danielje/Smart-Trap-Lighting-Hardware/Trap Light Programmable SpectrumV03 BOM New Variant 05-16-2018.xls

Bill of Materials for pc board: "Trap Light Programmable SpectrumV03.brd" as of 5-11-2018
Designator | Item | Quantity | for 120 | w overage | Designator | Description | Value | Package | Type | Manufacturer | Mfctr. Part Number | Distributor | Dstbr. Part # | Cost Each | Total parts cost | Incl. In Kit | Need for Build | Qty. To Return | Comments
TrapL1 | 1 | 1 | 120 | 125 | A1 | MODULE BLUETOOTH V2.1+EDR |  |  | smt | Microchip Technology (http://digikey.com/Suppliers/us/Microchip-Technology.page?lang=en) | RN42-I/RM | Digikey | 740-1038-1-ND | $15.44 | $15.44
TrapL2 | 2 | 4 | 480 | 580 | C1 - C4 | CAP CER 0.1UF 16V X7R 0805 | 0.1 uF | 0805 | smt | Johanson Dielectrics Inc. | 160R15W104KV4T | Digikey | 709-1183-1-ND | $0.06 | $0.22
TrapL3 | 3 | 2 | 240 | 340 | C5 - C6 | CAP CER 4.7UF 10V X7R 0805 | 4.7 uF | 0805 | smt | TDK Corporation | C2012X7R1A475M085AC | Digikey | 445-14528-1-ND | $0.08 | $0.15
TrapL4 | 4 | 6 | 720 | 820 | C7 - C12 | CAP CER 10UF 16V 20% X5R 0805 | 10 uF | 0805 | smt | TDK Corporation (http://digikey.com/Suppliers/us/TDK.page?lang=en) | C2012X5R1C106M085AC | Digikey | 445-7645-1-ND | $0.06 | $0.38
TrapL5 | 5 | 3 | 360 | 460 | C13 - C15 | CAP CER 22UF 16V 20% X5R 1206 | 22 uF | 1206 | smt | Taiyo Yuden (http://digikey.com/Suppliers/us/Taiyo-Yuden.page?lang=en) | EMK316BJ226ML-T | Digikey | 587-1433-1-ND | $0.14 | $0.41
TrapL6 | 6 | 1 | 120 | 220 | C16 | CAP CER 10PF 50V C0G/NP0 0805 | 10 pF | 0805 | smt | KEMET | C0805C100J5GACAUTO | Digikey | 399-6914-1-ND | $0.02 | $0.02
TrapL7 | 7 | 1 | 120 | 220 | C17 | CAP CER 1UF 25V Y5V 0805 | 1 uF | 0805 | smt | Samsung Electro-Mechanics America, Inc (http://digikey.com/Suppliers/us/samsung-electro-mechanics.page?lang=en) | CL21F105ZAFNNNE | Digikey | 1276-3009-1-ND | $0.02 | $0.02
TrapL8 | 8 | 3 | 360 | 460 | D1, D2 | DIODE SCHOTTKY 40V 1A SOD123 |  | SOD123 | smt | Nexperia USA Inc. (https://www.digikey.com/en/supplier-centers/n/nexperia) | PMEG4010CEGWX | Digikey | 1727-7337-1-ND | $0.12 | $0.37
TrapL9 | 9 | 1 | 120 | 145 | IC1 | IC CONTROLLR LI-ION 4.2V SOT23-5 |  | SOT23-5 | smt | Microchip Technology (http://digikey.com/Suppliers/us/Microchip-Technology.page?lang=en) | MCP73831T-2ACI/OT | Digikey | MCP73831T-2ACI/OTCT-ND | $0.42 | $0.42
TrapL10 | 10 | 1 | 120 | 145 | IC2 | IC VOLT DETECTOR 2CH LOP 6SOT |  | 6SOT | smt | Texas Instruments | TPS3710DDCR | Digikey | 296-43105-1-ND | $1.14 | $1.14
TrapL11 | 11 | 1 | 120 | 145 | IC3 | IC REG BUCK BST 3.3V 0.9A 10SON |  | 10SON | smt | Texas Instruments | TPS63031DSKR | Digikey | 296-39461-1-ND | $1.39 | $1.39
TrapL12 | 12 | 1 | 120 | 145 | IC4 | IC REG BUCK BOOST ADJ 2A 10WSON |  | 10WSON | smt | Texas Instruments | TPS63060DSCR | Digikey | 296-30204-1-ND | $1.74 | $1.74
TrapL13 | 13 | 1 | 120 | 145 | IC5 | IC MCU 8BIT 32KB FLASH 32TQFP |  | 32TQFP | smt | Atmel (http://digikey.com/Suppliers/us/Atmel.page?lang=en) | ATMEGA328P-AU | Digikey | ATMEGA328P-AURCT-ND | $1.70 | $1.70
TrapL14 | 14 | 6 | 720 | 745 | IC6 - IC11 | IC LED DRVR LIN DIM 40MA SC70-6 |  | SC-70-6 | smt | ams (http://digikey.com/Suppliers/us/Texas-Instruments.page?lang=en) | AS1102-T | Digikey | AS1102-TCT-ND | $0.59 | $3.52
TrapL15 | 15 | 1 | 120 | 25 | J1 | CONN HEADER PH SIDE 2POS 2MM SMD |  | JST | smt | JST Sales America Inc. (https://www.digikey.com/en/supplier-centers/j/jst) | S2B-PH-SM4-TB(LF)(SN) | Digikey | 455-1749-1-ND | $0.42 | $0.42
TrapL16 | 16 | 1 | 120 | 130 | J2 | CONN TERM BLK 2POS 2.5MM SMD |  |  | smt | Phoenix Contact (http://digikey.com/Suppliers/us/Phoenix-Contact.page?lang=en) | 1771091 | Digikey | 277-2072-1-ND | $0.64 | $0.64
TrapL17 | 17 | 1 | 120 | 145 | J3 | 2MM TERMINAL STRIP |  |  | smt | Samtec Inc. (https://www.digikey.com/en/supplier-centers/s/samtec) | TMM-102-01-F-S-SM | Digikey | SAM12135-ND | $0.23 | $0.23
TrapL18 | 18 | 2 | 240 | 265 | L1, L2 | FIXED IND 2.2UH 1.95A 66 MOHM |  |  | smt | TDK Corporation | VLF302512MT-2R2M | Digikey | 445-6780-1-ND | $0.99 | $1.97
TrapL19 | 19 | 1 | 120 | 145 | LED1 | LED 0.33W RED WTR CLR 3.5MM | red | 2-SMD | smt | TT Electronics/Optek Technology (http://digikey.com/Suppliers/us/TT-Electronics-Optek-Technology.page?lang=en) | OVS5MRBCR4 | Digikey | 365-1546-1-ND | $0.36 | $0.36
TrapL20 | 20 | 1 | 120 | 145 | LED2 | LED 0.33W AMBER WTR CLR 3.5MM | amber | 2-SMD | smt | TT Electronics/Optek Technology (http://digikey.com/Suppliers/us/TT-Electronics-Optek-Technology.page?lang=en) | OVS5MABCR4 | Digikey | 365-1543-1-ND | $0.36 | $0.36
TrapL21 | 21 | 1 | 120 | 145 | LED3 | LED 0.33W YELLOW WTR CLR 3.5MM | yellow | 2-SMD | smt | TT Electronics/Optek Technology (http://digikey.com/Suppliers/us/TT-Electronics-Optek-Technology.page?lang=en) | OVS5MYBCR4 | Digikey | 365-1549-1-ND | $0.36 | $0.36
TrapL22 | 22 | 1 | 90 | 115 | LED4 | LED LUXEON 3535L GREEN 530NM | green | 1414 (3535 Metric) | smt | Lumileds | L135-G525003500000 | Digikey | 1416-1984-1-ND | $0.57 | $0.57
TrapL23 | 23 | 1 | 120 | 145 | LED5 | LED 0.33W BLUE WTR CLR 3.5MM | blue | 2-SMD | smt | TT Electronics/Optek Technology (http://digikey.com/Suppliers/us/TT-Electronics-Optek-Technology.page?lang=en) | OVS5MBBCR4 | Digikey | 365-1544-1-ND | $0.36 | $0.36
TrapL24Variant1 | 24 | 1 | 90 | 115 | LED6 | LED 500MA 970MW 385NM | UV | 2-SMD | smt | Lite-On Inc. (https://www.digikey.com/en/supplier-centers/l/lite-on) | LTPL-C034UVH385 | Digikey | 160-2185CT-ND | $4.39 | $4.39
TrapL24Variant2 | 24 | 1 | 30 | 55 | LED6 | LED 500MA 665MW 365NM | UV | 2-SMD | smt | Lite-On Inc. (https://www.digikey.com/en/supplier-centers/l/lite-on) | LTPL-C034UVH365 | Digikey | 160-2184CT-ND | $4.34 | $4.34
TrapL25 | 25 | 1 | 120 | 220 | LED7 | LED RED DIFFUSED 0805 SMD | red | 0805 | smt | OSRAM Opto Semiconductors Inc. (http://digikey.com/Suppliers/us/Wurth-Electronics.page?lang=en) | LH R974-LP-1 | Digikey | 475-1415-1-ND | $0.49 | $0.49
TrapL26 | 26 | 7 | 840 | 940 | R1 - R7 | RES SMD 27K OHM 5% 1/8W 0805 | 27 kW | 0805 | smt | Panasonic Electronic Components (http://digikey.com/Suppliers/us/Panasonic-Electronic-Components.page?lang=en) | ERJ-6GEYJ273V | Digikey | P27KACT-ND | $0.01 | $0.08
TrapL27 | 27 | 1 | 120 | 220 | R8, R9 | RES SMD 4.7K OHM 5% 1/8W 0805 | 4.7 kW | 0805 | smt | Panasonic Electronic Components (http://digikey.com/Suppliers/us/Panasonic-Electronic-Components.page?lang=en) | ERJ-6GEYJ472V | Digikey | P4.7KACT-ND | $0.01 | $0.02
TrapL28 | 28 | 2 | 240 | 340 | R10, R11 | RES SMD 200K OHM 1% 1/8W 0805 | 200 kW | 0806 | smt | Panasonic Electronic Components (http://digikey.com/Suppliers/us/Panasonic-Electronic-Components.page?lang=en) | ERJ-6ENF2003V | Digikey | P200KCCT-ND | $0.01 | $0.01
TrapL29 | 29 | 1 | 120 | 220 | R12 | RES 2K OHM 1/8W 5% 0805 SMD | 2 kW | 0805 | smt | Panasonic Electronic Components (http://digikey.com/Suppliers/us/Panasonic-Electronic-Components.page?lang=en) | ERJ-6GEYJ202V | Digikey | P2.0KACT-ND | $0.00459 | $0.00459
TrapL30 | 30 | 1 | 90 | 190 | R13 | RES SMD 1.4M OHM 1% 1/8W 0805 | 1.4M | 0805 | smt | Panasonic Electronic Components (http://digikey.com/Suppliers/us/Panasonic-Electronic-Components.page?lang=en) | ERJ-6ENF1404V | Digikey | P1.4BTCT-ND | $0.01 | $0.01
TrapL31 | 31 | 1 | 120 | 220 | R14, R15 | RES SMD 1.2M OHM 1% 1/8W 0805 | 1.2 MW | 0805 | smt | Panasonic Electronic Components (http://digikey.com/Suppliers/us/Panasonic-Electronic-Components.page?lang=en) | ERJ-6ENF1204V | Digikey | P1.20MCCT-ND | $0.01 | $0.01
TrapL32 | 32 | 1 | 120 | 130 | USB1 | Connector Receptacle USB micro B 5 Position Surface Mount, Right Angle, Horizontal | micro-USB |  | smt | Wurth Electronics Inc (http://digikey.com/Suppliers/us/Wurth-Electronics.page?lang=en) | 629105136821 | Digikey | 732-3155-1-ND | $1.14 | $1.14
 |  | 32 | unique components
 |  | 59 | total components (all smd)
 |  |  |  |  |  |  |  |  |  |  |  |  | total |  | $41.48
