danielje/Smart-Trap-Lighting-Hardware/Trap Lighting Programmable SpectrumV03B.brd

## EAGLE design Trap Lighting Programmable SpectrumV03B.brd (2021-06-18)

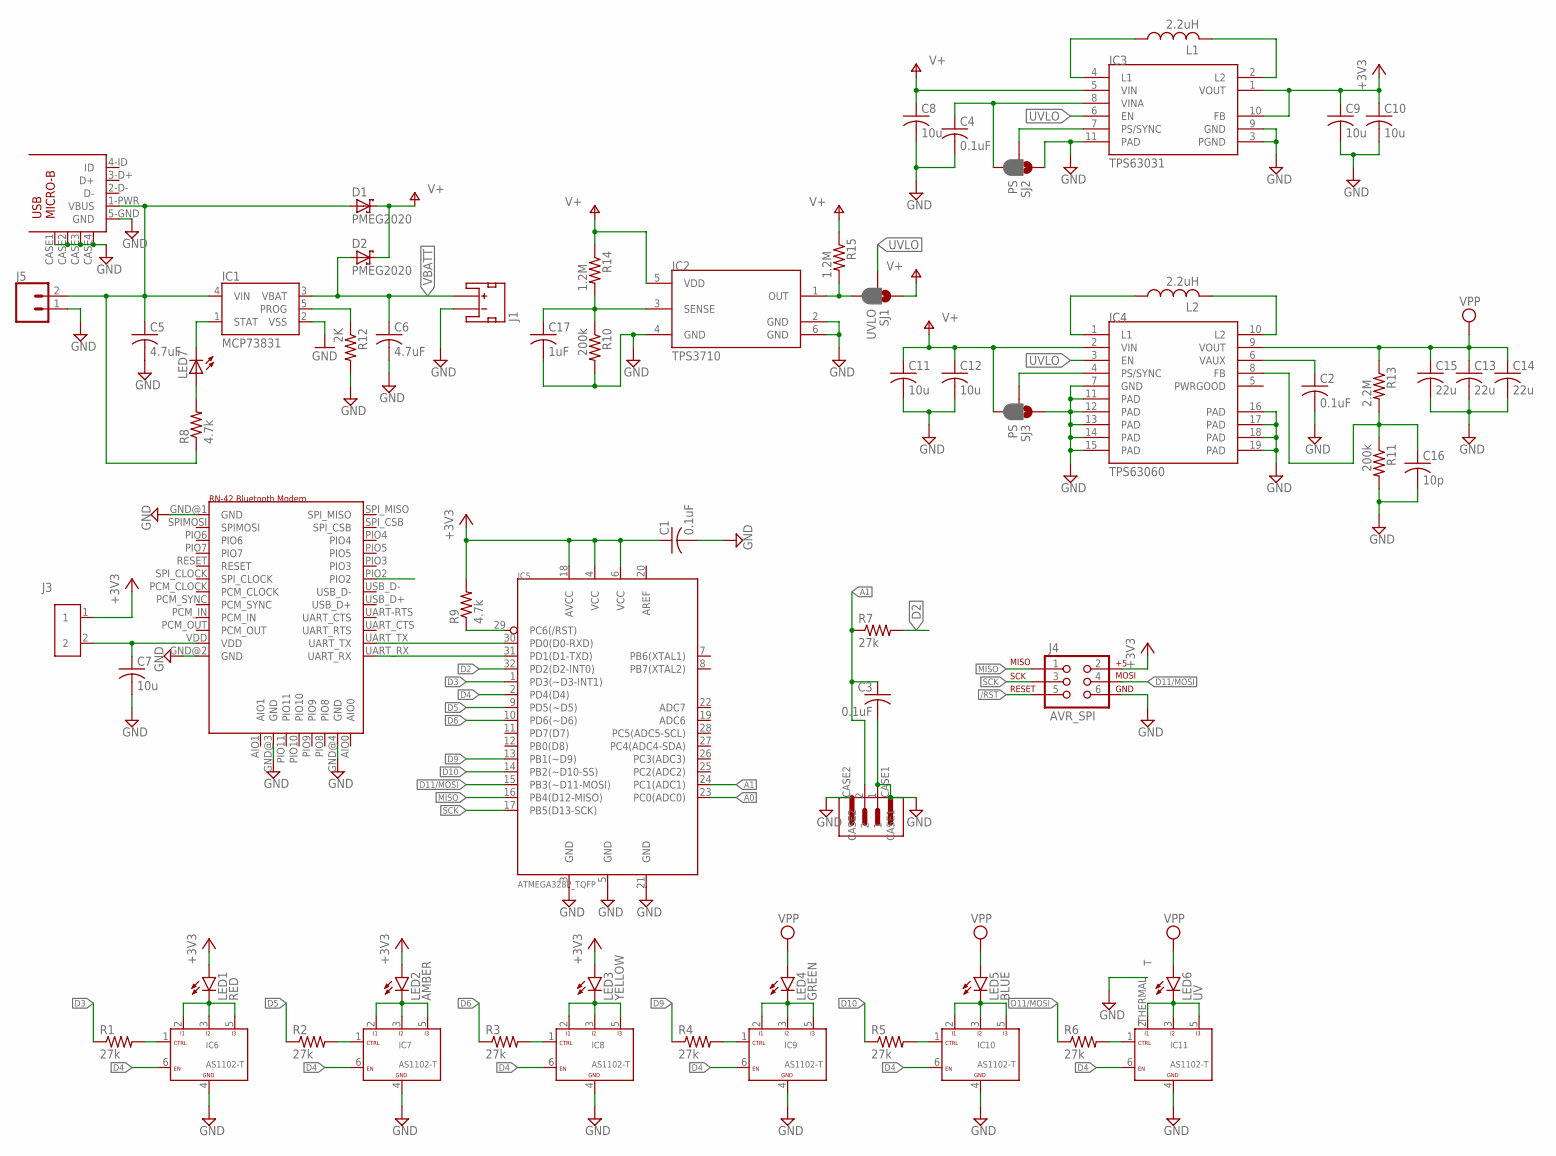
[picture p1: schematic Trap Lighting Programmable SpectrumV03B.sch]

Parts:
A1: RN-42_BLUETOOTH; RN-42
C1, C2, C3, C4: 0.1uF; C0805
C5, C6: 4.7uF; C0805
C7, C8, C9, C10, C11, C12: 10u; C0805
C13, C14, C15: 22u; C1206
C16: 10p; C0805
C17: 1uF; C0805
D1, D2: PMEG2020; SOD323_ST
IC1: MCP73831; SOT23-5
IC2: TPS3710; SOT6
IC3: TPS63031; VSON-10
IC4: TPS63060; WSON1-10
IC5: ATMEGA328P_TQFP; TQFP-32
IC6, IC7, IC8, IC9, IC10, IC11: AS1102-T; SC70-6
J1: JST_2MM_MALE; JST-2-SMD
J2: 2PIN_SMD_PHOENIX_CONTACTVERTICAL_PACKAGE; 2-PIN-VERT-PHOENIX_SMD
J3: 2MM_SMD_M_HEADER; 2MM_MALE_SMD_HEADER
J4: AVR_SPI; 2X3
J5: CONN_02PTH3; 1X02_LONGPADS
L1, L2: 2.2uH; VLF302512MT-2R2M-CA_INDUCTOR
LED1: RED; LED_TT_OVS5MX
LED2: AMBER; LED_TT_OVS5MX
LED3: YELLOW; LED_TT_OVS5MX
LED4: GREEN; LED_LUXEON_3535L
LED5: BLUE; LED_TT_OVS5MX
LED6: UV; LED_LITEON_CO3_UV
LED7: LEDCHIPLED_0805; CHIPLED_0805
R1, R2, R3, R4, R5, R6, R7: 27k; R0805
R8, R9: 4.7k; R0805
R10, R11: 200k; R0805
R12: 2K; R0805
R13: 2.2M; R0805
R14, R15: 1.2M; R0805
SJ1: UVLO; SMT-JUMPER_3_1-NC_PASTE_SILK
SJ2, SJ3: PS; SMT-JUMPER_3_1-NC_PASTE_SILK
USB1: USB-MICRO-B; USB_MICRO_B_WURTH_629105136821

Connections:
3.3V: C1.1, C9.1, C10.1, IC3.1 (VOUT), IC3.10 (FB), IC5.4 (VCC), IC5.6 (VCC), IC5.18 (AVCC), J3.1, J4.2, LED1.A, LED2.A, LED3.A, R9.2
/RST: IC5.29 (PC6(/RST)), J4.5, R9.1
A0: IC5.23 (PC0(ADC0))
A1: C3.1, IC5.24 (PC1(ADC1)), J2.2, R7.1
BT_CONNECT: A1.PIO2
D2: IC5.32 (PD2(D2-INT0)), R7.2
D3: IC5.1 (PD3(~D3-INT1)), R1.1
D4: IC5.2 (PD4(D4)), IC6.6 (EN), IC7.6 (EN), IC8.6 (EN), IC9.6 (EN), IC10.6 (EN), IC11.6 (EN)
D5: IC5.9 (PD5(~D5)), R2.1
D6: IC5.10 (PD6(~D6)), R3.1
D9: IC5.13 (PB1(~D9)), R4.1
D10: IC5.14 (PB2(~D10-SS)), R5.1
D11/MOSI: IC5.15 (PB3(~D11-MOSI)), J4.4, R6.1
GND: A1.GND@1 (GND), A1.GND@2 (GND), A1.GND@3 (GND), A1.GND@4 (GND), C1.2, C2.2, C3.2, C4.2, C5.2, C6.2, C7.2, C8.2, C9.2, C10.2, C11.2, C12.2, C13.2, C14.2, C15.2, C16.2, C17.2, IC1.2 (VSS), IC2.2 (GND), IC2.4 (GND), IC2.6 (GND), IC3.3 (PGND), IC3.9 (GND), IC3.11 (PAD), IC4.7 (GND), IC4.11 (PAD), IC4.12 (PAD), IC4.13 (PAD), IC4.14 (PAD), IC4.15 (PAD), IC4.16 (PAD), IC4.17 (PAD), IC4.18 (PAD), IC4.19 (PAD), IC5.3 (GND), IC5.5 (GND), IC5.21 (GND), IC6.4 (GND), IC7.4 (GND), IC8.4 (GND), IC9.4 (GND), IC10.4 (GND), IC11.4 (GND), J1.1 (-), J2.1, J2.CASE1, J2.CASE2, J4.6, J5.1, LED6.THERMAL (T), R10.2, R11.2, R12.2, SJ2.1, SJ3.1, USB1.5-GND (GND), USB1.CASE1 (CASE), USB1.CASE2 (CASE), USB1.CASE3 (CASE), USB1.CASE4 (CASE)
MCURX: A1.UART_TX, IC5.30 (PD0(D0-RXD))
MCUTX: A1.UART_RX, IC5.31 (PD1(D1-TXD))
MISO: IC5.16 (PB4(D12-MISO)), J4.1
unnamed: IC1.1 (STAT), LED7.C
unnamed: IC8.1 (CTRL), R3.2
unnamed: IC9.1 (CTRL), R4.2
unnamed: IC2.1 (OUT), R15.2, SJ1.3
unnamed: A1.VDD, C7.1, J3.2
unnamed: IC10.1 (CTRL), R5.2
unnamed: IC11.1 (CTRL), R6.2
unnamed: IC7.1 (CTRL), R2.2
unnamed: LED7.A, R8.2
unnamed: IC1.5 (PROG), R12.1
unnamed: C17.1, IC2.3 (SENSE), R10.1, R14.2
unnamed: IC3.2 (L2), L1.2
unnamed: IC3.4 (L1), L1.1
unnamed: IC3.7 (PS/SYNC), SJ2.2
unnamed: IC8.2 (I1), IC8.3 (I2), IC8.5 (I3), LED3.C
unnamed: IC9.2 (I1), IC9.3 (I2), IC9.5 (I3), LED4.C
unnamed: IC10.2 (I1), IC10.3 (I2), IC10.5 (I3), LED5.C
unnamed: IC11.2 (I1), IC11.3 (I2), IC11.5 (I3), LED6.K (C)
unnamed: IC7.2 (I1), IC7.3 (I2), IC7.5 (I3), LED2.C
unnamed: IC6.1 (CTRL), R1.2
unnamed: C4.1, IC3.8 (VINA), SJ2.3
unnamed: IC6.2 (I1), IC6.3 (I2), IC6.5 (I3), LED1.C
unnamed: IC4.4 (PS/SYNC), SJ3.2
unnamed: IC4.1 (L1), L2.1
unnamed: IC4.10 (L2), L2.2
unnamed: C2.1, IC4.6 (VAUX)
unnamed: C16.1, IC4.8 (FB), R11.1, R13.2
SCK: IC5.17 (PB5(D13-SCK)), J4.3
USB_VIN: C5.1, D1.A, IC1.4 (VIN), J5.2, R8.1, USB1.1-PWR (VBUS)
UVLO: IC3.6 (EN), IC4.3 (EN), SJ1.2
V+: C8.1, C11.1, C12.1, D1.C, D2.C, IC2.5 (VDD), IC3.5 (VIN), IC4.2 (VIN), R14.1, R15.1, SJ1.1, SJ3.3
VBATT: C6.1, D2.A, IC1.3 (VBAT), J1.2 (+)
VPP: C13.1, C14.1, C15.1, IC4.9 (VOUT), LED4.A, LED5.A, LED6.A, R13.1

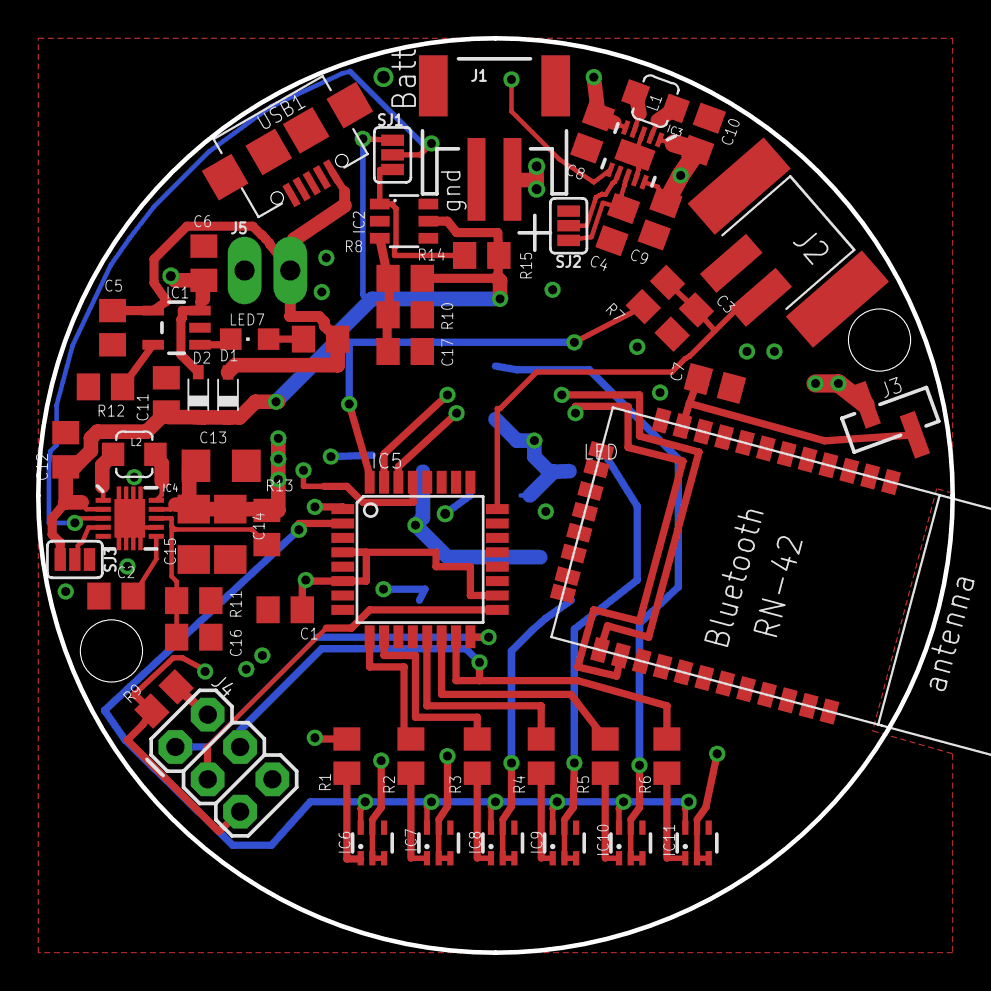
[picture p2: board Trap Lighting Programmable SpectrumV03B.brd from above]

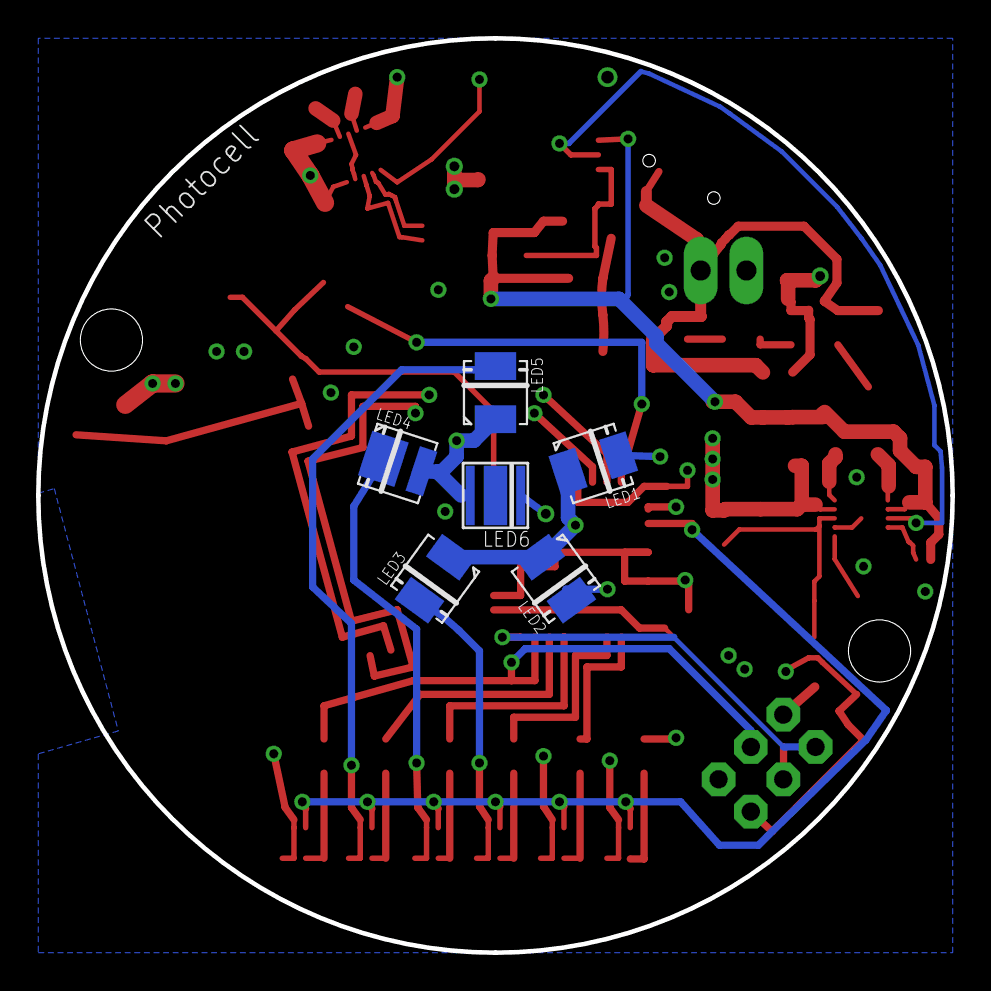
[picture p3: board Trap Lighting Programmable SpectrumV03B.brd from below]

Board: 4 copper layers, 50.8 x 50.8 mm, 64 parts (6 on the bottom side), 48 nets.
